openhardwarecoza/RGBSIGNAGE/README.md

# RGBSIGNAGE
Electronics and Firmware for an ESP8266 based RGB Sign
