openhardwarecoza/RGBSIGNAGE/rgbbOX2.brd

## EAGLE design rgbbOX2.brd (2018-10-23)

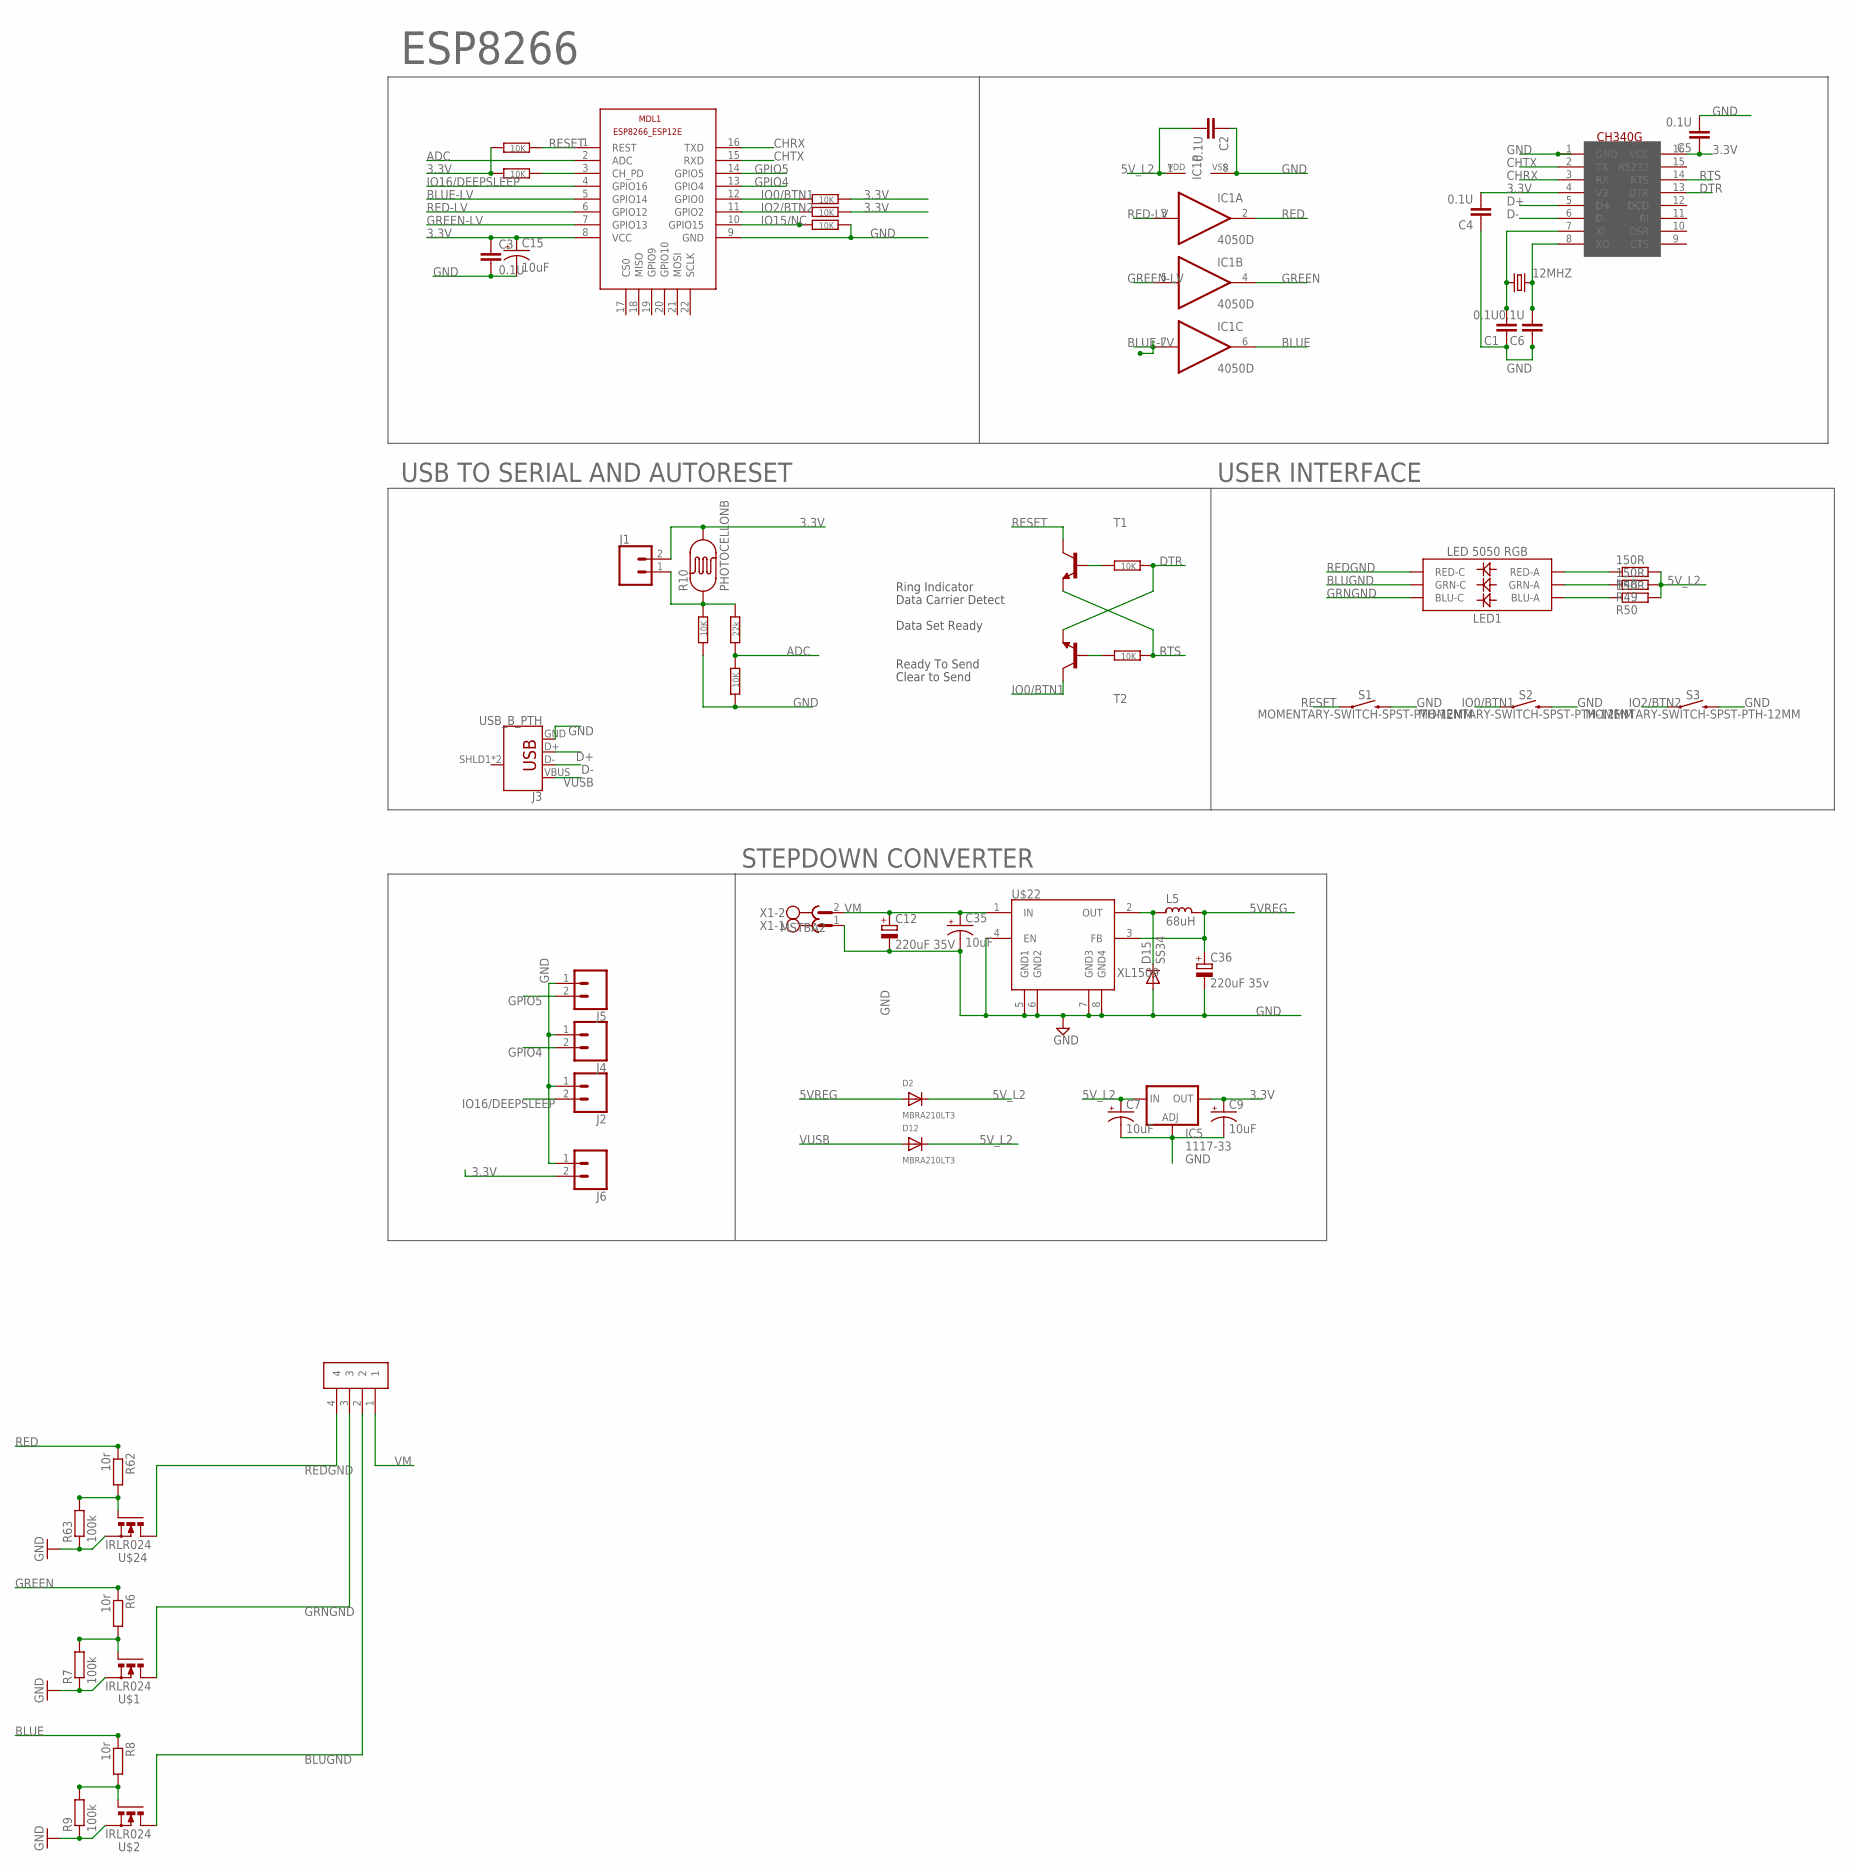
[picture p1: schematic rgbbOX2.sch, sheet 1, brains]

Parts:
12MHZ: CRYSTALHC49UP; HC49UP
C1, C2, C3, C4, C5, C6: 0.1U; C1206
C7, C9, C15, C35: 10uF; EIA3216
C12: 220uF 35V; E3,5-8
C36: 220uF 35v; E3,5-8
CON25: Phoenix Pluggable 3.81mm 4 way; 3.81MM-4WAY-PLUGGABLE-SCREW
D2, D12: MBRA210LT3; SMADIODE
D15: SS34; DO-214AC
IC1: 4050D; SO16
IC5: 1117-33; SOT223
J1, J2, J4, J5, J6: CONN_02LOCK; 1X02_LOCK
J3: USB_B_PTH; USB-B-PTH
L5: 68uH; CD75
LED1: LED 5050 RGB; LED-TRICOLOR-5050
MDL1: ESP8266-12EESP8266-ESP12E; ESP8266-ESP12E
R1, R2, R4, R5, R11, R12, R28, R29, R31: 10K; R1206
R3: 22k; R1206
R6, R8, R62: 10r; R1206
R7, R9, R63: 100k; R1206
R10: PHOTOCELLONB; ON_BOARD
R48, R49, R50: 150R; R1210
S1, S2, S3: MOMENTARY-SWITCH-SPST-PTH-12MM; TACTILE_SWITCH_PTH_12MM
T1, T2: MMBT2222ALT1-NPN-SOT23-BEC; SOT23-BEC
U$1, U$2, U$24: IRLR024; D-PAK_TO252AA
U$4: CH340G; SOIC16
U$22: XL1509; SO08
X1: MSTBA2

Connections:
3.3V: C3.1, C4.2, C5.1, C9.A (+), C15.A (+), IC5.4 (OUT), J1.2, J6.2, MDL1.8 (VCC), R10.2, R11.2, R12.2, R28.1, R29.1, U$4.4 (V3), U$4.16 (VCC)
5VREG: C36.+, D2.A, L5.1, U$22.3 (FB)
5V_L2: C2.2, C7.A (+), D2.C, D12.C, IC1.1 (VDD), IC5.3 (IN), R48.2, R49.2, R50.2
ADC: MDL1.2 (ADC), R3.1, R4.2
BLUE: IC1.6 (O), R8.1
BLUE-LV: IC1.7 (I), MDL1.5 (GPIO14)
BLUGND: CON25.2, LED1.6 (GRN-C), U$2.4 (D)
CHRX: MDL1.16 (TXD), U$4.3 (RX)
CHTX: MDL1.15 (RXD), U$4.2 (TX)
D+: J3.D+, U$4.5 (D+)
D-: J3.D-, U$4.6 (D-)
DTR: R1.2, T2.E, U$4.13 (DTR)
GND: C1.1, C2.1, C3.2, C4.1, C5.2, C6.1, C7.C (-), C9.C (-), C12.-, C15.C (-), C35.C (-), C36.-, D15.2 (A), IC1.8 (VSS), IC5.1 (ADJ), J2.1, J3.GND, J4.1, J5.1, J6.1, MDL1.9 (GND), R4.1, R5.1, R7.1, R9.1, R31.2, R63.1, S1.3 (2), S2.3 (2), S3.3 (2), U$1.3 (S), U$2.3 (S), U$4.1 (GND), U$22.4 (EN), U$22.5 (GND1), U$22.6 (GND2), U$22.7 (GND3), U$22.8 (GND4), U$24.3 (S), X1.1
GPIO4: J4.2, MDL1.13 (GPIO4)
GPIO5: J5.2, MDL1.14 (GPIO5)
GREEN: IC1.4 (O), R6.1
GREEN-LV: IC1.5 (I), MDL1.7 (GPIO13)
GRNGND: CON25.3, LED1.4 (BLU-C), U$1.4 (D)
IO0/BTN1: MDL1.12 (GPIO0), R12.1, S2.1, T2.C
IO2/BTN2: MDL1.11 (GPIO2), R11.1, S3.1
IO15/NC: MDL1.10 (GPIO15), R31.1
IO16/DEEPSLEEP: J2.2, MDL1.4 (GPIO16)
unnamed: R6.2, R7.2, U$1.1 (G)
unnamed: R62.2, R63.2, U$24.1 (G)
unnamed: D15.1 (C), L5.2, U$22.2 (OUT)
unnamed: 12MHZ.1, C1.2, U$4.7 (XI)
unnamed: 12MHZ.2, C6.2, U$4.8 (XO)
unnamed: R8.2, R9.2, U$2.1 (G)
unnamed: R1.1, T1.B
unnamed: R2.1, T2.B
unnamed: J1.1, R3.2, R5.2, R10.1
unnamed: MDL1.3 (CH_PD), R28.2
unnamed: LED1.3 (BLU-A), R50.1
unnamed: LED1.1 (GRN-A), R49.1
unnamed: LED1.2 (RED-A), R48.1
RED: IC1.2 (O), R62.1
RED-LV: IC1.3 (I), MDL1.6 (GPIO12)
REDGND: CON25.4, LED1.5 (RED-C), U$24.4 (D)
RESET: MDL1.1 (REST), R29.2, S1.1, T1.C
RTS: R2.2, T1.E, U$4.14 (RTS)
VM: C12.+, C35.A (+), CON25.1, U$22.1 (IN), X1.2
VUSB: D12.A, J3.VBUS

Notes on the sheet:
USB TO SERIAL AND AUTORESET
ESP8266
USER INTERFACE
Ring Indicator
Data Carrier Detect
Data Set Ready
Ready To Send
Clear to Send
STEPDOWN CONVERTER

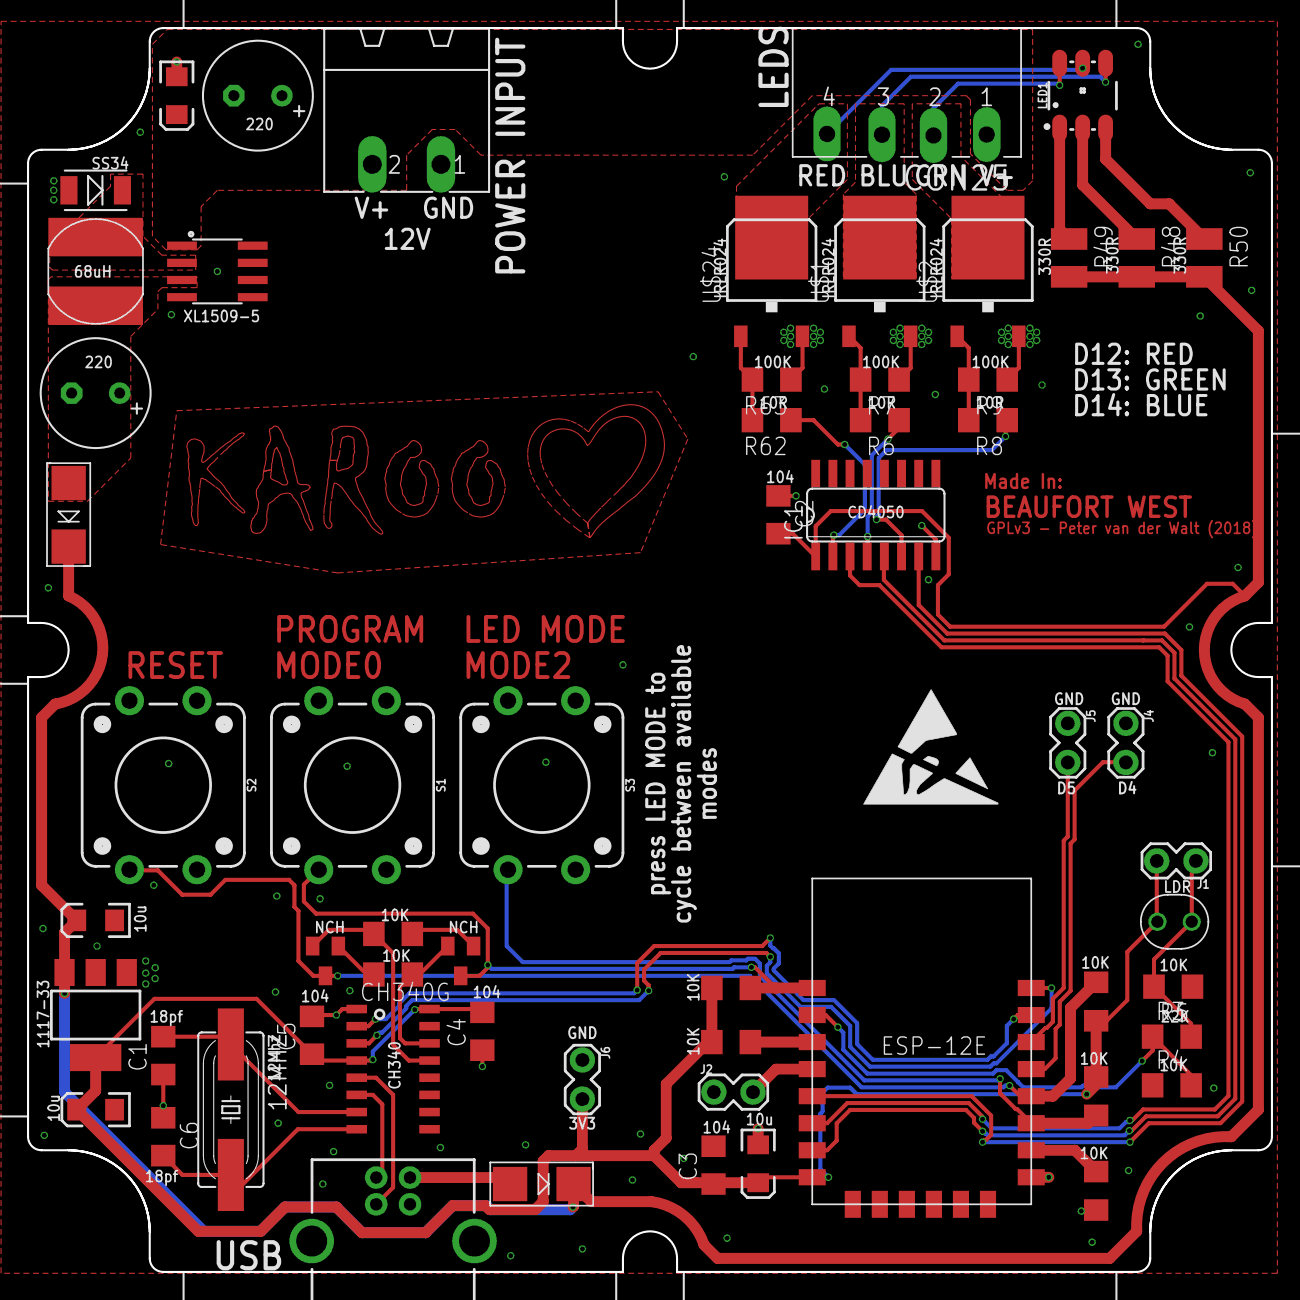
[picture p2: board rgbbOX2.brd from above]

Board: 2 copper layers, 92.0 x 92.0 mm, 60 parts (0 on the bottom side), 42 nets.

Other parts of the board:
U$3: ESD_10.00
