openhardwarecoza/RGBSIGNAGE/lightscontrollerasync/lightscontrollerasync.ino

/*
Firmware by Peter van der Walt for KarooHeart


TODO: Lightsensor 


*/

#include <ESP8266WiFi.h>
#include <ESP8266mDNS.h>
#include <FS.h>
#include <Hash.h>
#include <ESPAsyncTCP.h>
#include <ESPAsyncWebServer.h>
#include <DNSServer.h>
#include <ArduinoJson.h>

//  Uncomment to add Serial Prints - but comment for compile, too resource heavy
#define DEBUG

// SKETCH BEGIN
AsyncWebServer server(80);
AsyncWebSocket ws("/ws");
AsyncEventSource events("/events");
const byte DNS_PORT = 53;
DNSServer dnsServer;

char* ssid = "OPS_DSL";
char* password = "ffeeddccbbaa";
const char * hostName = "SignSetup";
const char compile_date[] = __DATE__ " " __TIME__;
int pin_btn0 = 0;
int pin_btn2 = 2;
int redval = 0;
int greenval = 0;
int blueval = 0;
int sequence = 1;
String scanssids = "";
unsigned long previousScanMillis = 0;
const long scanInterval = 30000;

#include "lightsensor.h" // RGB LED controller
#include "settings.h" // Save/Load settings from SPIFFS
#include "rgb.h" // RGB LED controller
#include "webserver.h" // onboard webserver
#include "websocket.h" // websocket for communication/feedback to/from the frontend webpages

void setup(){
  #ifdef DEBUG
    Serial.println("[1/9] Starting Serial...");
  #endif
  Serial.begin(115200);
  //Serial.setDebugOutput(true);

  #ifdef DEBUG
    Serial.println("[2/9] Starting Wifi Client...");
  #endif
  WiFi.hostname(hostName);
  WiFi.mode(WIFI_AP_STA);
  WiFi.begin(ssid, password);
  if (WiFi.waitForConnectResult() != WL_CONNECTED) {
    Serial.printf("STA: Failed!\n");
    WiFi.disconnect(false);
    delay(1000);
    WiFi.begin(ssid, password);
  }
  
  #ifdef DEBUG
    Serial.println("[3/9] Starting Wifi AP...");
  #endif
  WiFi.softAP(hostName, "Karoo100");

  #ifdef DEBUG
    Serial.println("[4/9] Starting mDNS...");
  #endif
  MDNS.addService("http","tcp",80);

  #ifdef DEBUG
    Serial.println("[4/9] Starting SPIFFS...");
  #endif
  uint32_t realSize = ESP.getFlashChipRealSize();
  uint32_t ideSize = ESP.getFlashChipSize();
  if (ideSize != realSize) {
    Serial.println("      Flash Chip configuration wrong!");
    Serial.printf( "      Flash real size: %u bytes\n", realSize);
    Serial.printf( "      Flash ide  size: %u bytes\n", ideSize);
  } else {
    Serial.println("      Flash Chip configuration ok.");
    Serial.printf( "      Flash real size: %u bytes\n", realSize);
    Serial.printf( "      Flash ide  size: %u bytes\n", ideSize);
  }
  SPIFFS.begin();
  
  #ifdef DEBUG
    Serial.println("[5/9] Loading configuration...");
  #endif
  if (!loadConfig()) {
    #ifdef DEBUG
      Serial.println("Failed to load config");
    #endif
  } else {
    #ifdef DEBUG
      Serial.println("Config loaded");
    #endif
  }
  
  #ifdef DEBUG
    Serial.println("[6/9] Starting Websocket Server...");
  #endif
  setupWebSocket();

  #ifdef DEBUG
    Serial.println("[7/9] Starting Webserver...");
  #endif
  setWebserver();
  
  #ifdef DEBUG
    Serial.println("[8/9] Starting RGB Controller...");
  #endif
  setupRGB();

  #ifdef DEBUG
    Serial.println("[9/9] Setting up Captive Portal...");  
  #endif
  /* Setup the DNS server redirecting all the domains to the apIP */
  IPAddress myIP = WiFi.softAPIP();
  dnsServer.setErrorReplyCode(DNSReplyCode::NoError);
  dnsServer.start(DNS_PORT, "*", myIP);


  scanforwifi();
}

void loop(){

  runLightSensor();

  bool btn2 = digitalRead(pin_btn2); 
  if (!btn2) {
    sequence++;
    delay(200);
    if (sequence == 9 || sequence > 9 ) {
      sequence = 1;
    }
    saveConfig();
  } 

  bool btn0 = digitalRead(pin_btn0); 
  if (!btn0) {
    forceon = !forceon;
    setColourRgb(1024, 1024, 1024);
    delay(200);  
    setColourRgb(0, 0, 0);
    saveConfig();
  } 

  if (forceon) { // then always turn on
    runProgram(sequence);  
  } else if (avg < lightthreshold) { // if its not in forceon mode, we check, is it dark? then turn on
    runProgram(sequence);  
  } else { // Not dark yet, so turn off.  Or its just turned morning. Off again. 
    setColourRgb(0, 0, 0);
  }
  
  dnsServer.processNextRequest();
  // Scan for new Wifi Networks
  unsigned long currentScanMillis = millis();
  if (currentScanMillis - previousScanMillis >= scanInterval) {
    // save the last time you blinked the LED
    previousScanMillis = currentScanMillis;
    scanforwifi();
  }
  
  
}
