openhardwarecoza/RGBSIGNAGE/lightscontroller/config.h

#define USE_SERIAL Serial // Serial Interface
#define BAUD (115200)  // Serial Baudrate

// Default Wifi
char ssid[] = "OPS_DSL";
char passphrase[] = "ffeeddccbbaa";

// Hardware Configuration
int pin_btn0 = 0;
int pin_btn2 = 2;
int redval = 0;
int greenval = 0;
int blueval = 0;
