openhardwarecoza/RGBSIGNAGE/(commit log)

2018-10-23 Working until you do a websocket call. Then the webserver stops responding. Need to switch to asyncwebserve
2018-10-24 Buttons and Wifi Select Sequence Working
2018-10-24 http params not working yet... commented out
    [settings.h, webserver.h]
