openhardwarecoza/RGBSIGNAGE/(notices)

Notices in the files:
rgbbOX2.brd:
GPLv3 - Peter van der Walt (2018)
parts and their libraries:
rc-master-smd: Copyright (C) 2007, Bob Starr
SparkFun-Connectors: Licensing: Creative Commons ShareAlike 4.0 International - https://creativecommons.org/licenses/by-sa/4.0
